edonD/sky130-cim/blocks/array/program.md

# CIM 64x64 Array -- Autonomous Design

You are designing the compute array for a compute-in-memory (CIM) tile on SKY130 130nm. The array is a 64x64 grid of SRAM CIM bitcells that performs a matrix-vector multiply (MVM) in the analog domain.

## Dependencies

This block depends on two upstream blocks being complete:

1. **Bitcell block** (`../bitcell/design.cir`) -- provides the 8T SRAM CIM bitcell subcircuit with pinout `(bl blb wl wwl q qb vdd vss)`. Read `../bitcell/measurements.json` for measured cell parameters (I_READ, I_LEAK, C_BL_CELL, etc.).

2. **PWM driver block** (`../pwm-driver/design.cir`) -- provides wordline driver subcircuits that convert 4-bit digital inputs into PWM pulses. Read `../pwm-driver/measurements.json` for driver parameters (T_LSB, T_MAX, rise/fall times).

See `../../interfaces.md` for the full interface contracts between all blocks.

## What This Block Does

The array tiles 64x64 bitcells into a grid where:
- Each **row** shares a wordline (WL) -- the input activation
- Each **column** shares a bitline (BL) -- the output accumulation line
- The stored weight matrix W[i][j] programs whether cell (i,j) conducts or not

### Operation (One Compute Cycle)

1. **Precharge phase:** Assert `rst` high. PMOS precharge transistors pull all 64 bitlines to VDD. All wordlines are low.

2. **Compute phase:** Deassert `rst`. Apply PWM-encoded input pulses on all 64 wordlines simultaneously. Each wordline pulse width is proportional to the corresponding input value (set by upstream PWM drivers). Cells with weight=1 discharge their bitline; cells with weight=0 do not.

3. **Settle phase:** All wordlines return low. Bitline voltages settle to their final values.

4. **Result:** The voltage on bitline j after compute is:
   ```
   V_BL[j] = VDD - (1/C_BL) * sum_i( W[i][j] * I_READ * T_pulse[i] )
   ```
   where the sum is over all 64 rows. This is the dot product of the input vector (encoded as pulse widths) and weight column j, expressed as a voltage drop.

5. The 64 bitline voltages are passed to downstream ADCs for digitisation.

## Parameters You Optimise

| Parameter | Role | Range |
|---|---|---|
| Wpre | Precharge PMOS width | 0.5--10 um |
| Lpre | Precharge PMOS length | 0.15--0.5 um |
| Tpre_ns | Precharge duration | 2--20 ns |
| Cbl_extra_ff | Extra bitline parasitic capacitance model | 0--100 fF |

The precharge transistors must be strong enough to pull all 64 bitlines to VDD within the precharge window, but not so large that they add excessive parasitic capacitance.

## What to Measure

1. **MVM RMSE (%):** Program a known weight matrix W, apply a known input vector x (via PWM pulse widths), read the 64 bitline voltages, convert to dot-product results, and compare against `numpy.matmul(W, x)`. Compute the normalised root-mean-square error across all 64 outputs. Repeat for 10 random test vectors and report the average. Target: < 10%.

2. **Max Error (%):** The worst single-element error across all test vectors. Target: < 20%.

3. **Compute Time (ns):** Time from first wordline activation to the point where all bitlines have settled (within 1% of final value). Target: < 100 ns.

4. **Power (mW):** Total array power during one compute cycle (precharge + compute + settle). Target: < 5 mW.

## Simulation Strategy

- **Start with an 8x8 sub-array** for fast simulation iteration and optimisation. Verify correctness at this scale first.
- **Scale to 64x64** for final validation. The bitline capacitance scales linearly with the number of rows (64 cells per column), so the 8x8 results can be extrapolated, but a full-scale verification is required for sign-off.
- Use the bitcell's measured `C_BL_CELL` to model the total bitline capacitance: `C_BL_total = N_rows * C_BL_CELL + C_BL_extra`.

## Key Challenges

- **Bitline capacitance grows with array size:** 64 cells per column adds significant capacitance. The precharge must be strong enough, and the voltage swing must still be large enough for ADC resolution.
- **Charge sharing and parasitic coupling:** Adjacent bitlines can couple capacitively, causing crosstalk errors.
- **Cell linearity:** Each cell must contribute current linearly with pulse width. If any cell's read transistors enter triode region or saturate differently, the dot-product is distorted.
- **IR drop along wordlines and bitlines:** Long metal lines have resistance. Cells at the far end of a wordline or bitline may see reduced voltage, causing systematic errors.
- **Precharge uniformity:** All 64 bitlines must reach VDD to within a few mV before compute begins. Incomplete precharge causes offset errors.

## Interface

- **Inputs:** 64 wordline pulses (from PWM drivers), weight programming interface (WWL, BLW, BLBW)
- **Outputs:** 64 bitline voltages (to ADCs)
- **Port order:** `(wl[63:0] bl[63:0] pre rst wwl[63:0] blw[63:0] blbw[63:0] vdd vss)`

## Files

| File | Editable? | Purpose |
|---|---|---|
| `design.cir` | YES | Parametric SPICE netlist for the CIM array |
| `parameters.csv` | YES | Parameter names, min, max, scale |
| `evaluate.py` | YES | Simulation runner, MVM verification, scoring |
| `specs.json` | **NO** | Target specifications |

## Technology

- **PDK:** SkyWater SKY130 (130nm)
- **Devices:** `sky130_fd_pr__nfet_01v8`, `sky130_fd_pr__pfet_01v8`
- **Supply:** 1.8V single supply
- **Models:** `.lib "sky130_models/sky130.lib.spice" tt`

## Commit Rule

Every meaningful result must be committed and pushed:
```bash
git add -A && git commit -m '<description>' && git push
```

---

---

---

# Autonomous Experiment Loop

This section defines how the autonomous agent operates. It applies to every block in the CIM project.

**Remember the big picture:** This block is part of a Compute-in-Memory chip that will perform neural network inference in the analog domain. Every design decision, every waveform, every plot should be evaluated through that lens. Ask yourself: "Will this work when 64 of these are wired together on a shared bitline?" or "Will this ADC correctly digitise a signal that came from an analog dot product?" The block in isolation means nothing — it must work in the system.

## You Have Full Freedom — Use It

You are not limited to what's in this repo. You have access to the entire internet and you should use it aggressively:

- **Search the web** for state-of-the-art designs. Look up ISSCC papers, JSSC publications, IEEE Xplore, ResearchGate, university thesis PDFs. Find what the best analog designers in the world have done for this exact type of circuit.
- **Search for SKY130 examples.** Other people have designed similar circuits on the SKY130 PDK — find their repos on GitHub, read their netlists, learn from their parameter choices.
- **Look up design techniques.** If you're stuck on offset, search "SRAM bitcell offset reduction techniques." If your ADC has missing codes, search "SAR ADC missing codes root cause." If your comparator is too slow, search "StrongARM comparator speed optimization."
- **Read textbooks and course notes online.** Razavi, Allen-Holberg, Murmann lecture slides — many are freely available and contain exact design equations you can use.
- **Find application notes and design guides.** Companies like Analog Devices, TI, and Maxim publish detailed design guides for ADCs, comparators, and memory circuits.
- **Study the competition.** Search for Mythic AI architecture, IBM analog AI ISSCC papers, academic SRAM-CIM papers from KAIST, MIT, Stanford. Understand what the best CIM designs look like and steal their best ideas.
- **pip install anything you need.** If a better optimizer exists (optuna, cma, bayesian-optimization), install it. If you need a plotting library, install it. You have full access.

Do whatever you think is necessary to produce the best possible design. There are no restrictions on your research methods. The only constraint is the specs in `specs.json` — everything else is fair game.

## Setup (do this once at the start)

1. Read `program.md` for the full design brief and architecture.
2. Read `specs.json` for the pass/fail targets. These are the only hard constraints.
3. Read `../../interfaces.md` for signal contracts with other blocks.
4. Read `../../verification.md` for mandatory testbenches and plots.
5. Read `design.cir`, `parameters.csv`, `evaluate.py` for current state.
6. Initialize `results.tsv` with the header row:
   ```
   step	commit	score	specs_met	notes
   ```
7. Run `bash setup.sh` if SKY130 models are not already set up.
8. Confirm everything works: run a quick simulation to verify ngspice + PDK.

Once setup is confirmed, begin the experiment loop. Do NOT ask for permission.

## The Experiment Loop

**LOOP FOREVER:**

1. **Think.** Look at the current state: which specs pass, which fail, what's the margin. Read the waveforms. Decide what to try next.

2. **Modify.** Change `design.cir`, `parameters.csv`, `evaluate.py`, or write an optimization script. You can modify any file EXCEPT `specs.json`.

3. **Commit.** `git add -A && git commit -m '<what you changed>'`

4. **Run.** Execute the simulation or optimization. Redirect output:
   ```bash
   python evaluate.py > run.log 2>&1
   ```
   Or run your own optimizer script.

5. **Read results.** Extract the key metrics:
   ```bash
   grep "score\|PASS\|FAIL\|worst" run.log | tail -20
   ```
   If grep is empty, the run crashed. Read `tail -50 run.log` for the error. Fix and re-run. If you can't fix after 3 attempts, log it as a crash and move on.

6. **Log.** Append to `results.tsv`:
   ```
   <step>	<commit>	<score>	<specs_met>	<description of what you tried>
   ```

7. **Decide.**
   - If the result is **better** (higher score, more specs met, or better margins): **keep it**. This is now your new baseline. Update README.md with the latest numbers and plots.
   - If the result is **equal or worse**: **revert**. `git reset --hard HEAD~1`. Try something else.

8. **Repeat.** Go back to step 1.

## Two Phases

### Phase A: Meet All Specs

Your first priority is getting ALL specs to pass. This means score = 1.0 with every measurement meeting its target. During this phase:

- Focus on the specs that are failing. Ignore margin optimization.
- Try the obvious things first: sensible default parameters, textbook designs.
- If a spec is way off, rethink the topology or approach — don't just tweak parameters.
- When you get stuck, read the waveforms. The circuit is telling you what's wrong.
- Even during Phase A, plot waveforms after every successful run. You need to see what the circuit is doing — numbers alone are not enough.

### Phase B: Deep Verification & Margin Improvement (after all specs pass)

Once all specs pass, this is where the real engineering begins. You are no longer just hitting targets — you are proving this circuit is ready to be part of a CIM chip.

#### B.1 — Waveform Analysis (MANDATORY after every keeper)

After every run that you keep, you MUST:

1. **Plot the key waveforms** and save them to `plots/`. Every plot must have:
   - Clear axis labels (time in ns, voltage in V, current in uA)
   - A descriptive title that states what the plot shows
   - Annotation of key events (e.g., "CLK rises here", "latch regenerates", "code transition")

2. **Study every waveform critically.** For each plot, ask yourself:
   - Does this look like what the textbook says it should? If not, why?
   - Are there any sharp jumps, glitches, or ringing? If so, what causes them? Is it a simulation artifact or a real problem?
   - Is the signal settling cleanly, or is it still moving when we sample it?
   - Are the voltage levels correct? (e.g., does a "high" output actually reach VDD? Does a "low" reach VSS?)
   - Is there any unexpected current flow? Leakage where there shouldn't be?

3. **If something looks wrong, investigate before moving on.** A waveform anomaly is more important than a passing spec number. The spec might pass by accident while the circuit is doing something broken.

4. **If data is missing or a measurement returns zero/NaN**, do not ignore it. Explain why in the README. Common causes:
   - The simulation didn't run long enough
   - A node is floating
   - The circuit is in a metastable state
   - The measurement trigger condition was never met

5. **If there are sharp jumps or discontinuities in any plot**, explain them in the README:
   - Is it a clock edge? Label it.
   - Is it charge injection from a switch? Quantify it.
   - Is it a convergence artifact? Check with finer timestep.
   - Is it clipping? Check operating regions.

#### B.2 — System-Level Thinking

Remember that this block will be integrated into a CIM tile. After each improvement, ask:

- **Bitcell agent:** "If 64 of these cells share a bitline, will the currents sum linearly? Is there any interaction between cells that breaks superposition?"
- **ADC agent:** "When the input comes from a CIM bitline (not a clean voltage source), will this ADC still work? What about the bitline's output impedance and settling behavior?"
- **PWM agent:** "When this pulse drives 64 cell gates simultaneously, will the edges still be sharp? What's the actual RC delay?"
- **Array agent:** "Does the precharge fully restore the bitline? Is there residual charge from the previous cycle affecting the next computation?"
- **Integration agent:** "Does the end-to-end error budget close? Bitcell nonlinearity + ADC quantization + PWM jitter — do they add up to less than the accuracy target?"

#### B.3 — README.md as the Progress Dashboard

**README.md is how the human monitors your progress.** They will read ONLY the README to understand what you've done, what works, what doesn't, and what the circuit looks like. Write it for a designer who has never seen this block before.

README.md MUST contain (update after every keeper):

1. **Status banner** at the top: which specs pass, which fail, current score.

2. **Spec table** with measured values, targets, margin percentage, and pass/fail:
   ```
   | Spec | Target | Measured | Margin | Status |
   ```

3. **Waveform plots** — the most important ones, embedded as `![description](plots/filename.png)`. For each plot, include:
   - One sentence explaining what the plot shows
   - One sentence explaining what to look for (what "good" looks like)
   - If anything is anomalous, explain it

4. **Design parameters** — current values in a table.

5. **Design rationale** — why you chose this topology, why these sizes. Not just "optimiser found these" but the engineering reason.

6. **What was tried and rejected** — a brief log of approaches that didn't work and why. This prevents the next agent (or a human) from repeating dead ends.

7. **Known limitations** — honest assessment. What are the weak points? What would break first if this went to silicon?

8. **Experiment history** — summary table of all runs (can reference results.tsv).

**If a README section has no data yet**, don't delete the section — write "Pending: will be updated after [next step]" so the human knows it's planned.

**If a plot shows unexpected behavior**, don't hide it. Show the plot, annotate the anomaly, and explain your hypothesis for what's causing it. Honest reporting is more valuable than clean-looking results.

#### B.4 — Verification Plots Checklist

Refer to `../../verification.md` for the full list of mandatory testbenches and plots for your block. During Phase B, systematically work through every testbench. For each one:

1. Run the testbench simulation
2. Save the plot to `plots/` with the exact filename specified in verification.md
3. Add the plot to README.md with analysis
4. If the testbench reveals a problem, fix the design and re-run

Do not consider Phase B complete until every testbench in verification.md has been run and every plot has been generated.

#### B.5 — Margin Improvement

After all verification plots are done, continue improving:

- Run PVT corner sweeps if applicable. Worst-case numbers matter.
- Run Monte Carlo if applicable. Statistical yield matters.
- Reduce power, reduce area, increase speed — in that priority order.
- A design with 40% margin everywhere is better than one with 0% margin that barely passes.
- Try simplifying: fewer transistors, smaller sizes, less complexity. If you can remove something and still pass, that's a win.

**NEVER STOP.** Even after all specs pass, all plots are generated, and margins are good, keep looking for improvements. Simplify the circuit. Reduce transistor count. Find a cleaner topology. The loop runs until the human interrupts you.

## Logging Rules

- `results.tsv` is tab-separated (NOT comma-separated).
- Every run gets logged, even crashes.
- Do NOT commit `results.tsv` — leave it untracked so it doesn't create merge conflicts.
- DO commit and push `best_parameters.csv`, `measurements.json`, plots, and README.md after every improvement.

## Crash Handling

- If a simulation crashes (ngspice error, convergence failure, Python error):
  - Read the error. If it's a typo or easy fix, fix and re-run.
  - If the approach is fundamentally broken (e.g., impossible operating point), revert and try something different.
  - Log "crash" in results.tsv and move on.
  - Never spend more than 3 attempts on a single failing approach.

## Git Discipline

- Every experiment gets its own commit BEFORE running (so you can revert cleanly).
- Keep commits: stay on the current commit.
- Discard experiments: `git reset --hard HEAD~1` to go back.
- Push after every keeper: `git push` so progress is saved remotely.
- Never rewrite history that's already pushed. Only reset un-pushed commits.

## NEVER STOP

Once the experiment loop begins, do NOT pause to ask the human anything. Do NOT ask "should I continue?" or "is this good enough?". The human may be away for hours. You are fully autonomous.

If you run out of ideas:
- Re-read the waveforms. Look at every node. The circuit is telling you something.
- Re-read `../../verification.md` for testbenches you haven't run yet.
- Try combining two previous near-miss approaches.
- Try a completely different topology or optimization algorithm.
- Read the program.md again for hints you may have missed.
- Try shrinking the design (fewer transistors, smaller sizes, less power).
- Re-read `../../interfaces.md` — think about how your block connects to the others. Is there an interface issue you haven't considered?

The loop runs until the human manually stops you.
