edonD/sky130-cim/blocks/adc/plots/dnl_inl_hires.png

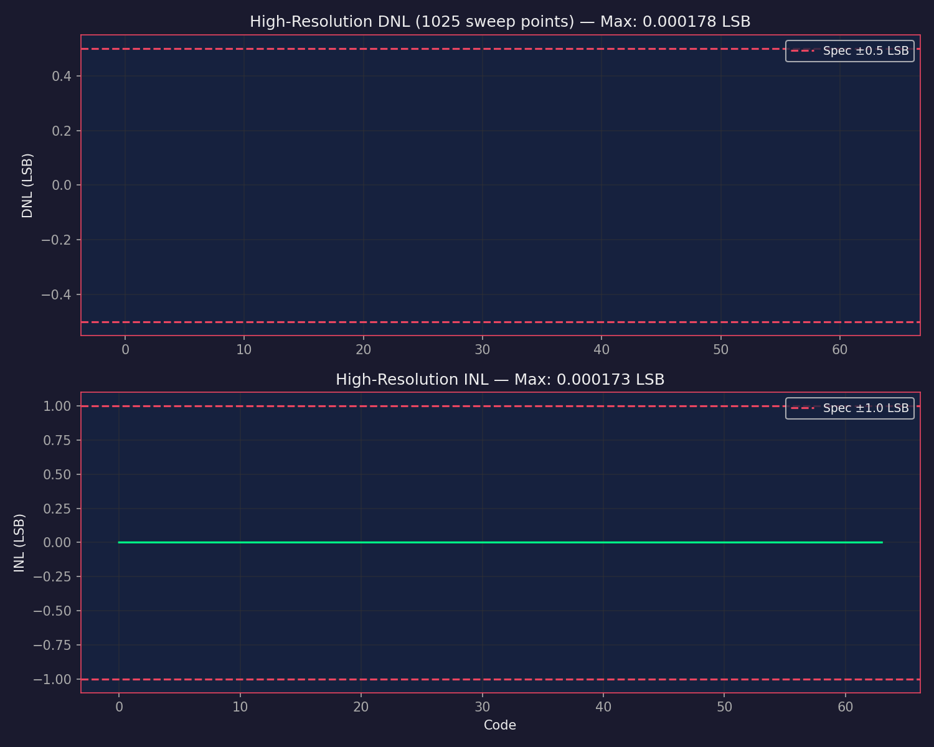
blocks/adc/plots/dnl_inl_hires.png
