edonD/sky130-cim/blocks/adc/plots/dnl_inl_mismatch_overlay.png

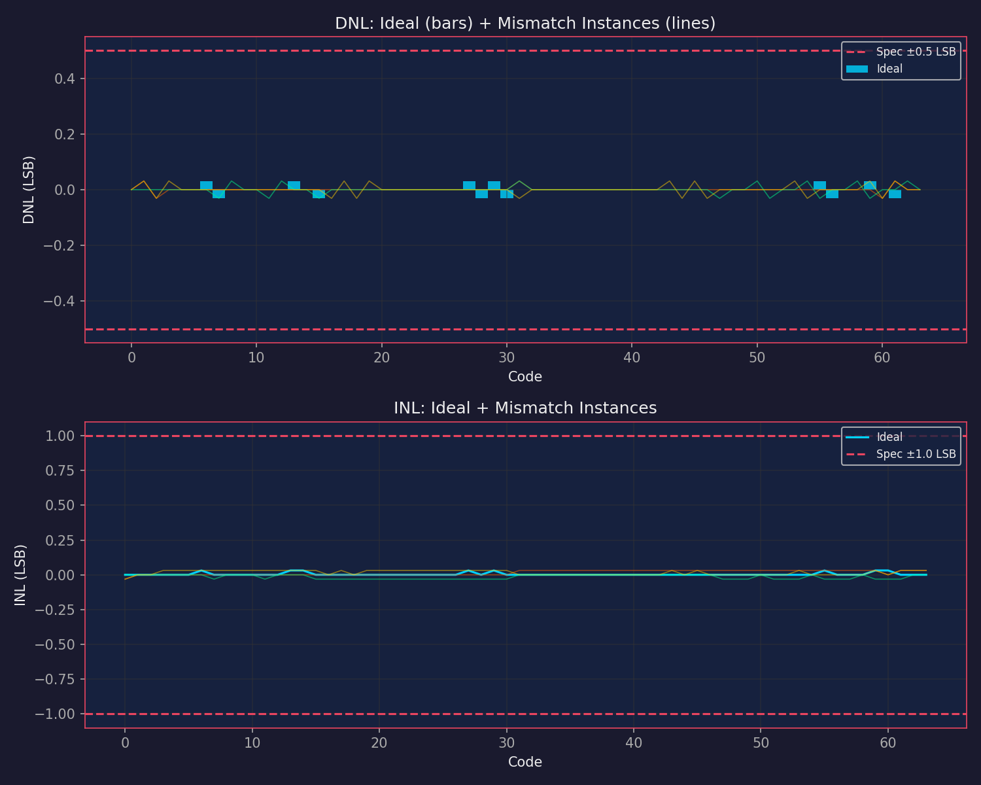
blocks/adc/plots/dnl_inl_mismatch_overlay.png
