edonD/sky130-cim/blocks/adc/plots/pareto_frontier.png

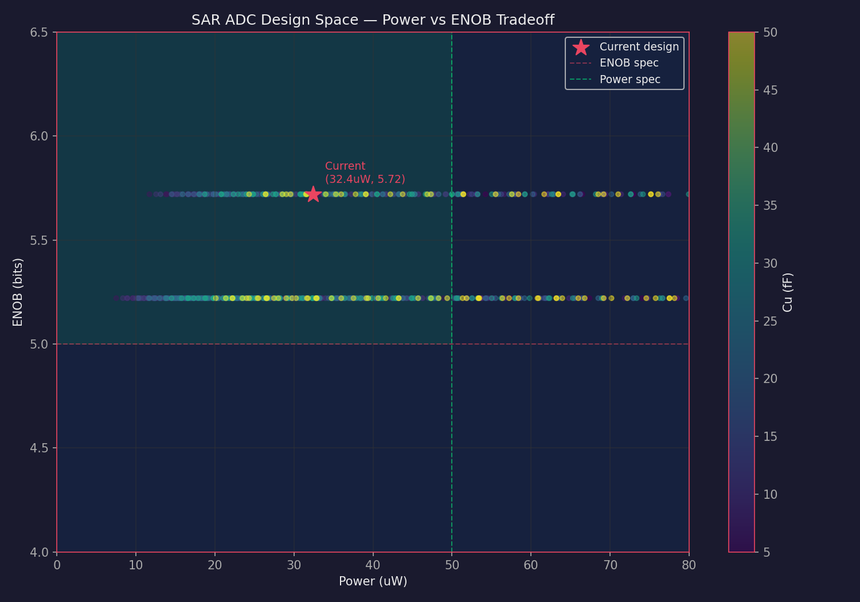
blocks/adc/plots/pareto_frontier.png
