edonD/sky130-cim/blocks/adc/plots/progress.png

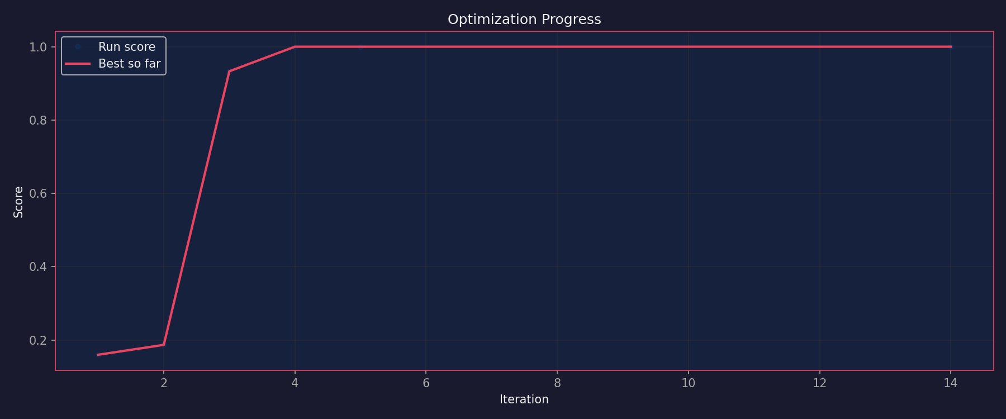
blocks/adc/plots/progress.png
