edonD/sky130-cim/blocks/bitcell/plots/progress.png

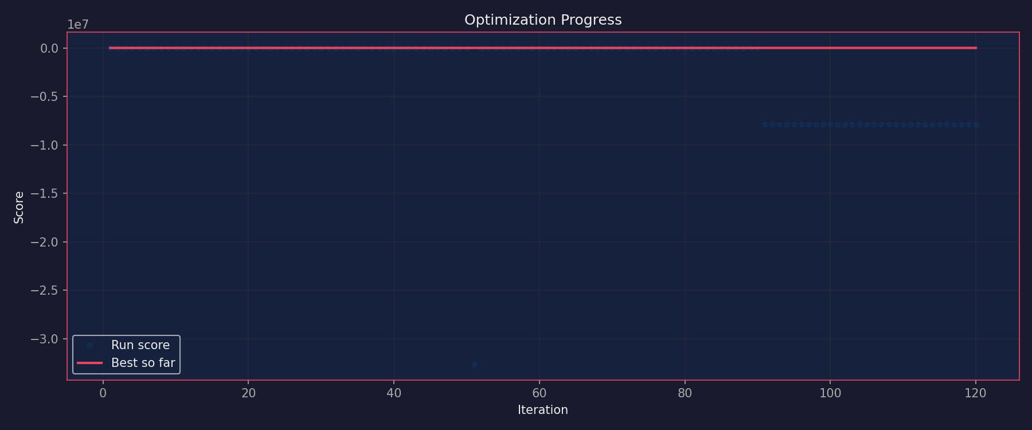
blocks/bitcell/plots/progress.png
