edonD/sky130-cim/blocks/bitcell/results.tsv

step | score | i_read_ua | i_leak_na | on_off | t_read_ns
1 | 6.85 | 665.242 | 0.002 | 301482391.2 | 0.052
2 | -62.13 | 1010.070 | 0.003 | 300613387.4 | 0.057
3 | 8.19 | 658.279 | 0.002 | 321175942.5 | 0.075
4 | 8.00 | 659.209 | 0.002 | 302640724.6 | 0.077
5 | 31.36 | 542.448 | 0.002 | 230869215.5 | 0.077
6 | 6.85 | 665.242 | 0.002 | 301482391.2 | 0.050
7 | 60.90 | 394.882 | 0.002 | 193938471.2 | 0.060
8 | -57.19 | 984.303 | 0.002 | 432134500.0 | 0.163
9 | 120.65 | 96.189 | 0.002 | 51444027.9 | 0.057
10 | -421.77 | 2807.740 | 0.002 | 1312328523.8 | 0.111
11 | 59.02 | 404.327 | 0.002 | 203569144.9 | 0.059
12 | -71.13 | 100.484 | 0.002 | 54088504.0 | 0.761
13 | -111.43 | 1250.170 | 0.003 | 485544396.0 | 0.698
14 | -131.76 | 275.958 | 0.002 | 141079937.0 | 0.138
15 | -29.82 | 113.825 | 0.002 | 60043466.6 | 0.081
16 | -237.87 | 868.690 | 0.002 | 397404284.7 | 0.581
17 | 75.47 | 321.929 | 0.002 | 163777376.4 | 0.072
18 | 124.53 | 76.801 | 0.002 | 41256976.8 | 0.056
19 | 122.10 | 88.291 | 0.002 | 47774242.6 | 0.120
20 | -362.16 | 139.435 | 0.002 | 73878327.4 | 0.161
21 | 128.79 | 55.322 | 0.002 | 29145724.7 | 0.071
22 | 115.88 | 120.144 | 0.002 | 65368125.5 | 0.047
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
