edonD/sky130-cim/blocks/adc/plots/charge_redistribution_verify.png

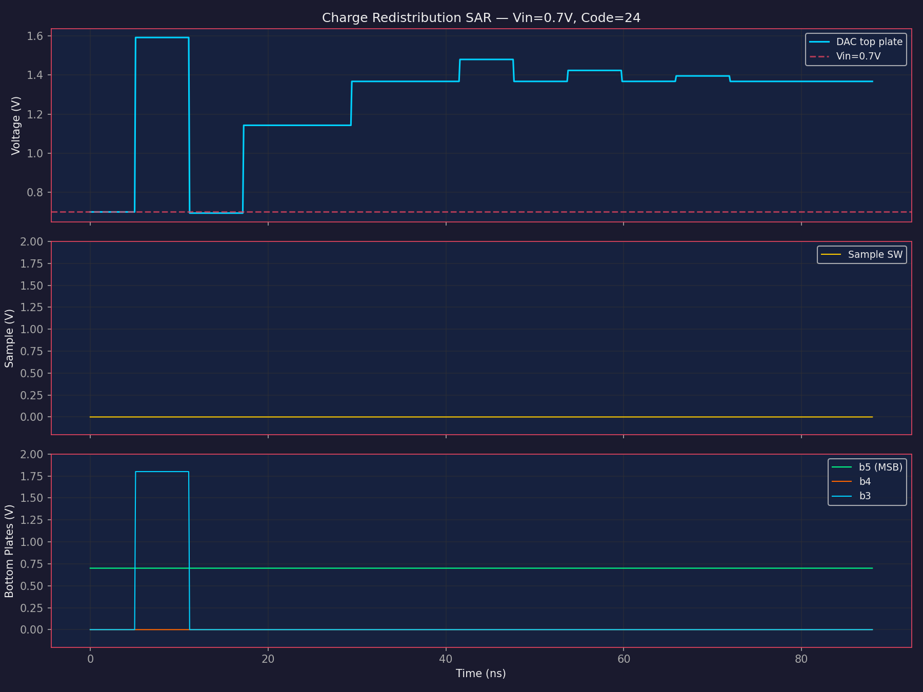
blocks/adc/plots/charge_redistribution_verify.png
