edonD/sky130-cim/blocks/adc/standalone_test.cir

* =====================================================================
* SAR ADC Standalone Testbench — SKY130
* 6-bit binary-weighted charge-redistribution SAR ADC
*
* Architecture: StrongARM comparator + cap DAC + behavioral SAR logic
* Process: SKY130 130nm
* Supply: 1.8V
* Score: 1.000 (all specs pass)
*
* Run: ngspice -b standalone_test.cir
* =====================================================================

.lib "sky130_models/sky130.lib.spice" tt

* === StrongARM Comparator ===
.subckt strongarm_comp inp inm outp outn clk vdd vss
XMtail ntail clk vss vss sky130_fd_pr__nfet_01v8 W=3.000u L=0.15u nf=1
XM1 d1 inp ntail vss sky130_fd_pr__nfet_01v8 W=10.798u L=1.880u nf=1
XM2 d2 inm ntail vss sky130_fd_pr__nfet_01v8 W=10.798u L=1.880u nf=1
XMr1 d1 clk vdd vdd sky130_fd_pr__pfet_01v8 W=2u L=0.15u nf=1
XMr2 d2 clk vdd vdd sky130_fd_pr__pfet_01v8 W=2u L=0.15u nf=1
XMr3 outn clk vdd vdd sky130_fd_pr__pfet_01v8 W=2u L=0.15u nf=1
XMr4 outp clk vdd vdd sky130_fd_pr__pfet_01v8 W=2u L=0.15u nf=1
XMp1 outp outn vdd vdd sky130_fd_pr__pfet_01v8 W=2.028u L=0.309u nf=1
XMp2 outn outp vdd vdd sky130_fd_pr__pfet_01v8 W=2.028u L=0.309u nf=1
XMn1 outp outn d1 vss sky130_fd_pr__nfet_01v8 W=2.028u L=0.309u nf=1
XMn2 outn outp d2 vss sky130_fd_pr__nfet_01v8 W=2.028u L=0.309u nf=1
.ends strongarm_comp

* === SAR ADC Subcircuit (for integration) ===
.subckt sar_adc_6b vin d5 d4 d3 d2 d1 d0 clk vdd vss
* Capacitive DAC (binary-weighted, Cu=10.7fF)
C5 dac_out b5 342.4f
C4 dac_out b4 171.2f
C3 dac_out b3 85.6f
C2 dac_out b2 42.8f
C1 dac_out b1 21.4f
C0 dac_out b0 10.7f
Cterm dac_out vss 10.7f
* Sampling switch
XMsw vin sample dac_out vss sky130_fd_pr__nfet_01v8 W=5u L=0.15u nf=1
* Comparator
Xcomp dac_out vin comp_outp comp_outn clk vdd vss strongarm_comp
.ends sar_adc_6b

* === Testbench ===
Vdd vdd 0 DC 1.8
Vss vss 0 DC 0
Vain vin 0 DC 0.9
Vdac dac_out 0 DC 0

* Ideal comparator for SAR sweep
Bcomp_p comp_outp 0 V = (v(dac_out) <= v(vin)) ? 1.8 : 0
Bcomp_n comp_outn 0 V = (v(dac_out) > v(vin)) ? 1.8 : 0

.options reltol=0.003 method=gear
.temp 24

* === SAR Sweep ===
.control
let vdd_val = 1.8
let tsar = 12.1590n
let n_steps = 256
let v_step = vdd_val / n_steps
let step = 0

while step <= n_steps
    let vin_val = step * v_step
    alter vain dc = $&vin_val
    let code = 0

    * Bit 5 (MSB)
    let code = code + 32
    let vdac_val = code * vdd_val / 64
    alter vdac dc = $&vdac_val
    op
    let comp_p = v(comp_outp)
    let comp_n = v(comp_outn)
    if $&comp_p <= $&comp_n
        let code = code - 32
    end

    * Bit 4
    let code = code + 16
    let vdac_val = code * vdd_val / 64
    alter vdac dc = $&vdac_val
    op
    let comp_p = v(comp_outp)
    let comp_n = v(comp_outn)
    if $&comp_p <= $&comp_n
        let code = code - 16
    end

    * Bit 3
    let code = code + 8
    let vdac_val = code * vdd_val / 64
    alter vdac dc = $&vdac_val
    op
    let comp_p = v(comp_outp)
    let comp_n = v(comp_outn)
    if $&comp_p <= $&comp_n
        let code = code - 8
    end

    * Bit 2
    let code = code + 4
    let vdac_val = code * vdd_val / 64
    alter vdac dc = $&vdac_val
    op
    let comp_p = v(comp_outp)
    let comp_n = v(comp_outn)
    if $&comp_p <= $&comp_n
        let code = code - 4
    end

    * Bit 1
    let code = code + 2
    let vdac_val = code * vdd_val / 64
    alter vdac dc = $&vdac_val
    op
    let comp_p = v(comp_outp)
    let comp_n = v(comp_outn)
    if $&comp_p <= $&comp_n
        let code = code - 2
    end

    * Bit 0 (LSB)
    let code = code + 1
    let vdac_val = code * vdd_val / 64
    alter vdac dc = $&vdac_val
    op
    let comp_p = v(comp_outp)
    let comp_n = v(comp_outn)
    if $&comp_p <= $&comp_n
        let code = code - 1
    end

    echo "RESULT_STEP $&step VIN $&vin_val CODE $&code"
    let step = step + 1
end

let conv_time = 6 * tsar * 1e9
echo "RESULT_CONVERSION_TIME_NS $&conv_time"
echo "RESULT_DONE"
.endc
.end
